NKID00/xlink033/README.md

# xlink033

Ultra-affordable debug probe built around the 30 cent MCU CH32X033F8P6, featuring:

- Bootstrap select button, so you won't need yet another probe to unbrick the probe itself!
- 5V and 3V3 dual switchable current-limited output
- RVSWD/SDI, JTAG/SWD, UART and RST signal
- Full-speed USB
- Link and activity indicator LED

### License

Hardware part (directory `hw/`) is distributed under CERN-OHL-S-2.0 or any later version.

<sub>
Copyright (C) 2025 NKID00 <br>
This source describes Open Hardware and is licensed under the CERN-OHL-S v2 or any later version. <br>
You may redistribute and modify this source and make products using it under the terms of the CERN-OHL-S v2 (https://ohwr.org/cern_ohl_s_v2.txt). <br>
This source is distributed WITHOUT ANY EXPRESS OR IMPLIED WARRANTY, INCLUDING OF MERCHANTABILITY, SATISFACTORY QUALITY AND FITNESS FOR A PARTICULAR PURPOSE. Please see the CERN-OHL-S v2 for applicable conditions. <br>
As per CERN-OHL-S v2 section 4, should You produce hardware based on this source, You must where practicable maintain the Source Location (https://github.com/NKID00/xlink033) visible on the external case of the Gizmo or other products you make using this source. <br>
</sub><br>

Software part (directory `sw/`) is distributed under GPL-3.0-or-later.

<sub>
Copyright (C) 2025 NKID00 <br>
This program is free software: you can redistribute it and/or modify it under the terms of the GNU General Public License as published by the Free Software Foundation, either version 3 of the License, or (at your option) any later version. <br>
This program is distributed in the hope that it will be useful, but WITHOUT ANY WARRANTY; without even the implied warranty of MERCHANTABILITY or FITNESS FOR A PARTICULAR PURPOSE.  See the GNU General Public License for more details. <br>
You should have received a copy of the GNU General Public License along with this program.  If not, see &le;https://www.gnu.org/licenses/&gt;.
</sub>
