NKID00/xlink033/hw/xlink033.pdf

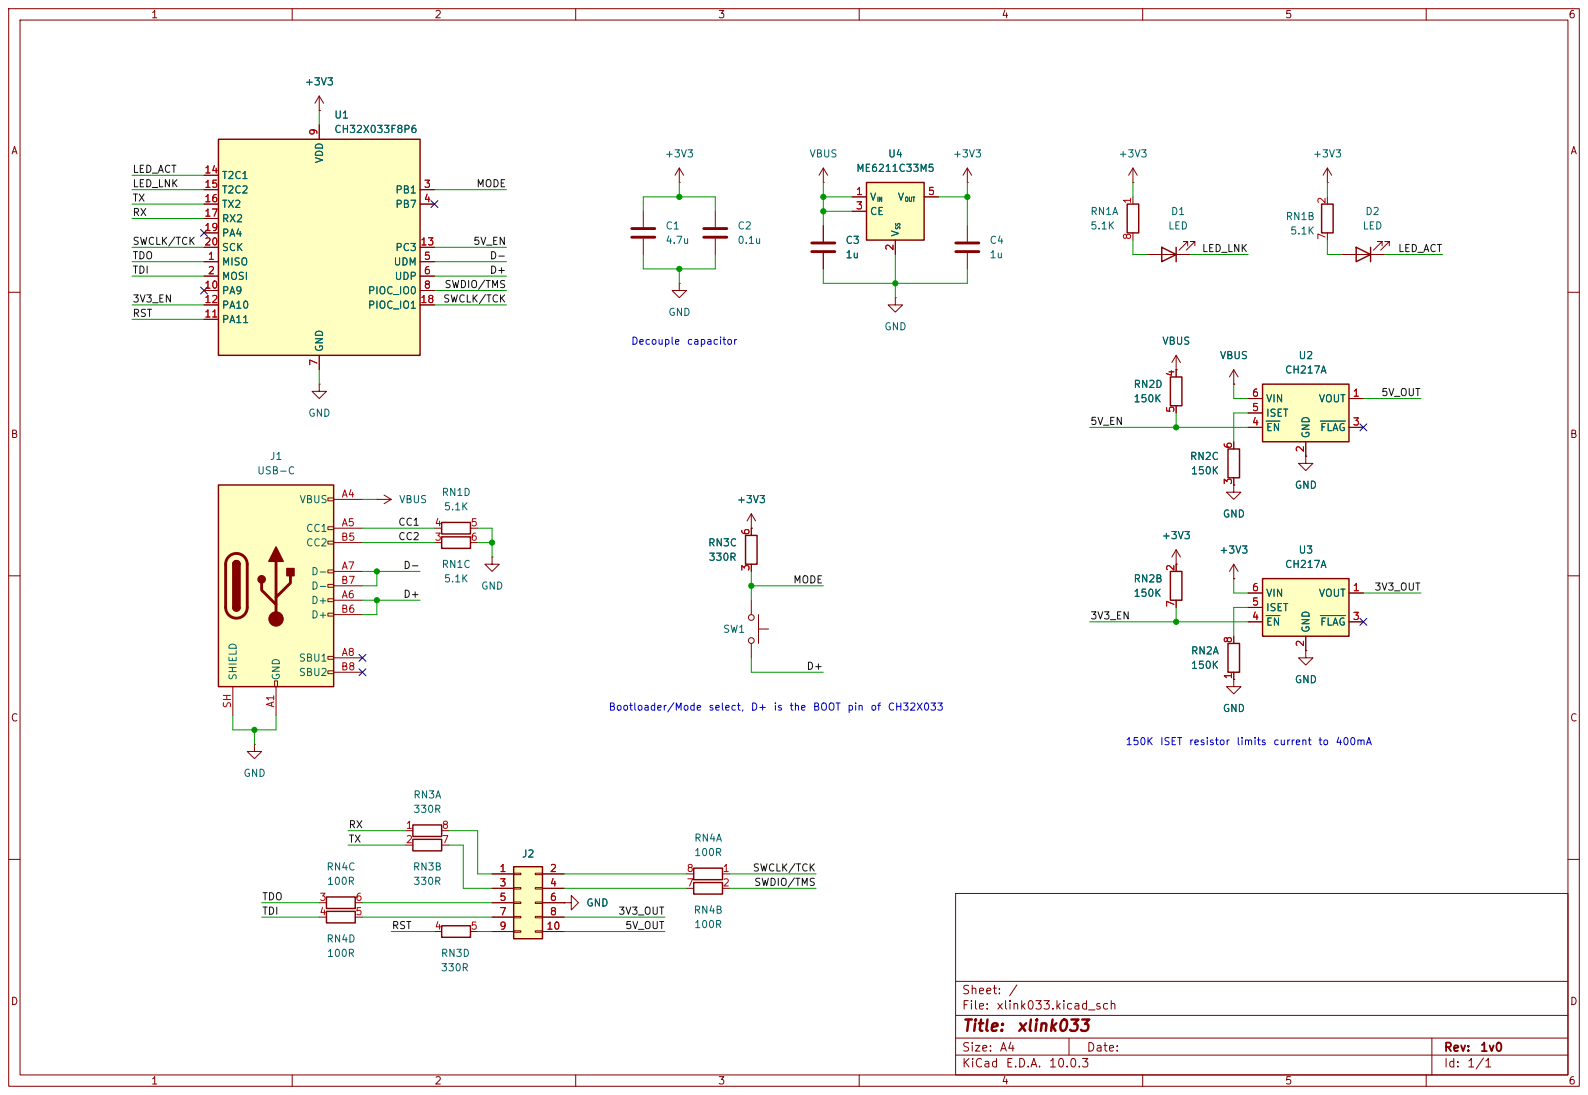
[picture p1: page 1]

9 MISO 1 MOSI 2 PB1 3 PB7 4 UDM 5 UDP 6 PIOC_IO0 8 PA9 10 PA11 11 PA10 12 PC3 13

Size: A4 | Rev: 1v0
KiCad E.D.A. 10.0.3 | Id: 1/1
