NKID00/xlink033/hw/xlink033.kicad_pcb

## KiCad design hw/xlink033.kicad_pcb (2026-09-29)

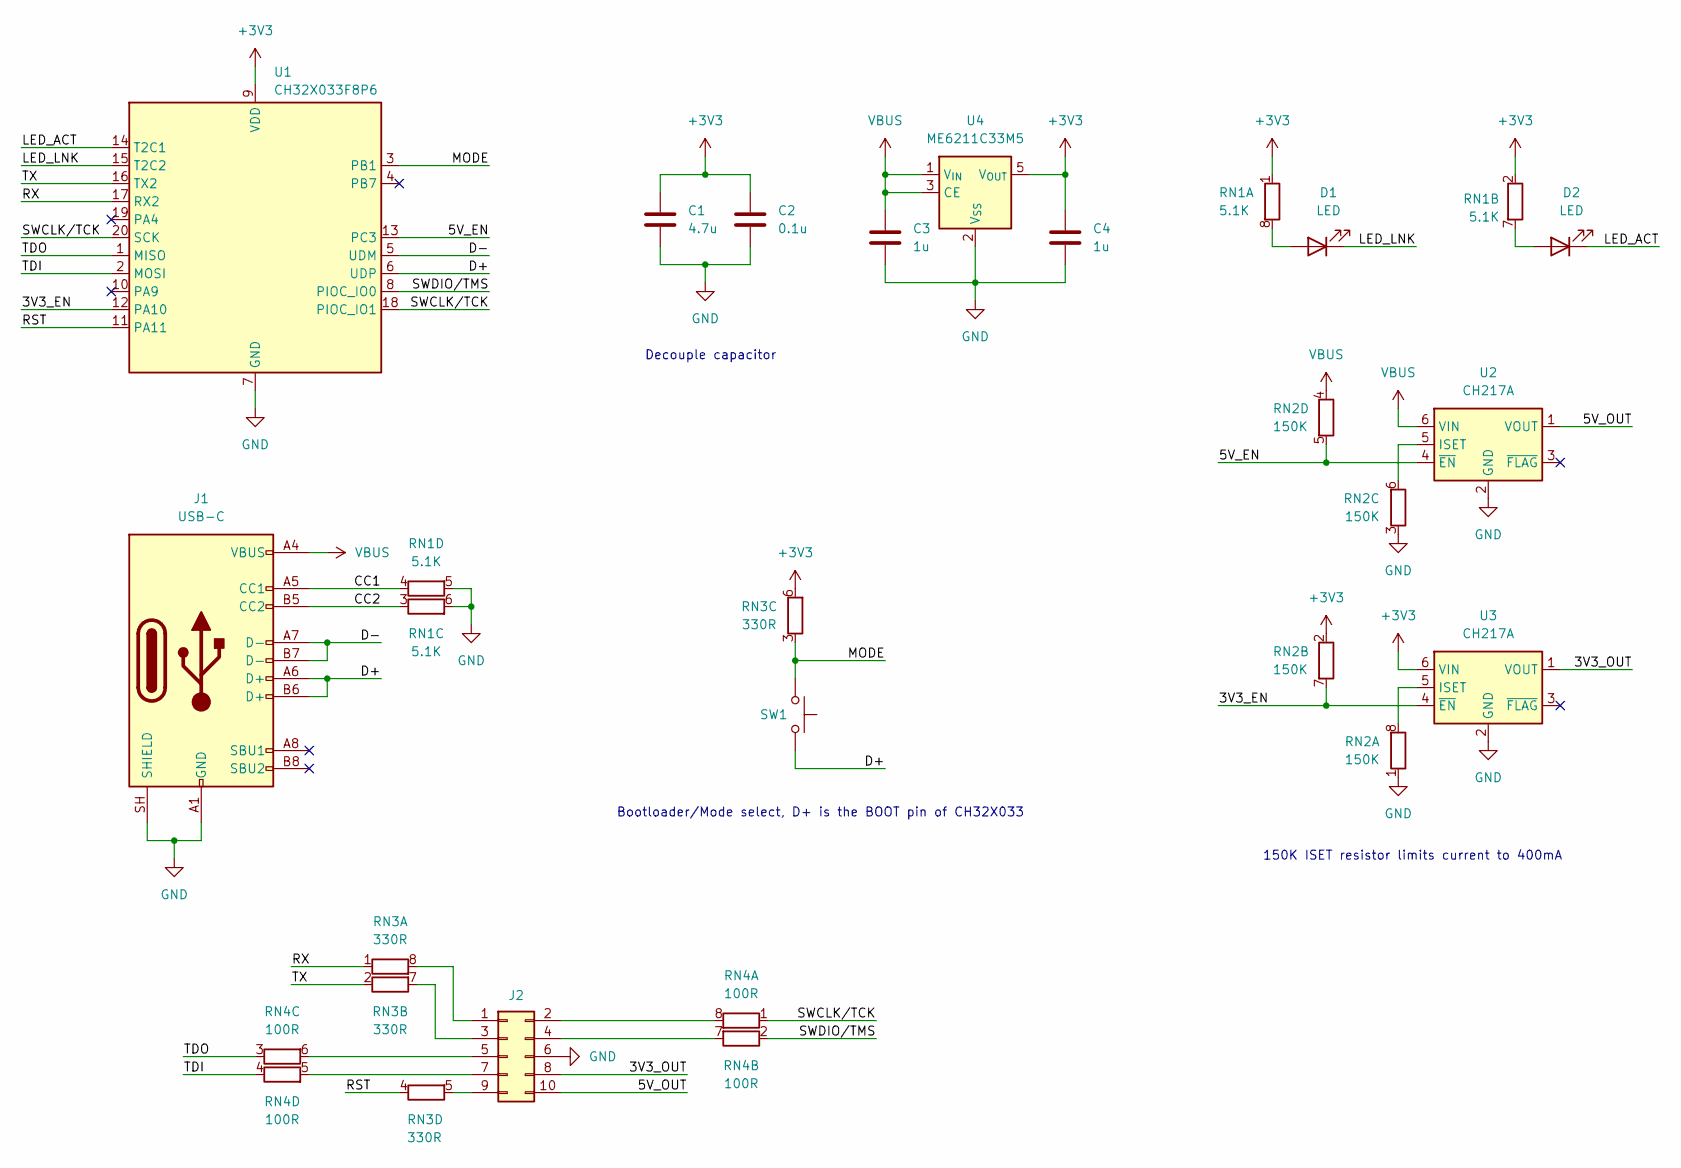
[picture p2: schematic xlink033.kicad_sch]

Parts:
C1: 4.7u; C_0603_1608Metric
C2: 0.1u; C_0603_1608Metric
C3, C4: 1u; C_0603_1608Metric
D1, D2: LED; LED_0603_1608Metric
J1: USB-C; USB_C_Receptacle_GCT_USB4105-xx-A_16P_TopMnt_Horizontal
J2: PinHeader_2x05_P2.54mm_Horizontal
RN1: 5.1K; R_Array_Convex_4x0603
RN2: 150K; R_Array_Convex_4x0603
RN3: 330R; R_Array_Convex_4x0603
RN4: 100R; R_Array_Convex_4x0603
SW1: SW_SPST_TS-1088-xR020
U1: CH32X033F8P6; TSSOP-20_4.4x6.5mm_P0.65mm
U2, U3: CH217A; SOT-23-6
U4: ME6211C33M5; SOT-23-5

Connections:
+3V3: C1.1, C2.1, C4.1, RN1.1 (R1.1), RN1.2 (R2.1), RN2.2 (R2.1), RN3.6 (R3.2), U1.9 (VDD), U3.6 (VIN), U4.5 (V_{OUT})
/3V3_EN: RN2.7 (R2.2), U1.12 (PA10), U3.4 (~EN)
/3V3_OUT: J2.8, U3.1 (VOUT)
/5V_EN: RN2.5 (R4.2), U1.13 (PC3), U2.4 (~EN)
/5V_OUT: J2.10, U2.1 (VOUT)
/CC1: J1.A5 (CC1), RN1.4 (R4.1)
/CC2: J1.B5 (CC2), RN1.3 (R3.1)
/D+: J1.A6 (D+), J1.B6 (D+), SW1.2, U1.6 (UDP)
/D-: J1.A7 (D-), J1.B7 (D-), U1.5 (UDM)
/LED_ACT: D2.1 (K), U1.14 (T2C1)
/LED_LNK: D1.1 (K), U1.15 (T2C2)
/MODE: RN3.3 (R3.1), SW1.1, U1.3 (PB1)
/RST: RN3.4 (R4.1), U1.11 (PA11)
/RX: RN3.1 (R1.1), U1.17 (RX2)
/SWCLK/TCK: RN4.1 (R1.1), U1.18 (PIOC_IO1), U1.20 (SCK)
/SWDIO/TMS: RN4.2 (R2.1), U1.8 (PIOC_IO0)
/TDI: RN4.4 (R4.1), U1.2 (MOSI)
/TDO: RN4.3 (R3.1), U1.1 (MISO)
/TX: RN3.2 (R2.1), U1.16 (TX2)
GND: C1.2, C2.2, C3.2, C4.2, J1.A1 (GND), J1.A12 (GND), J1.B1 (GND), J1.B12 (GND), J1.SH (SHIELD), J2.6, RN1.5 (R4.2), RN1.6 (R3.2), RN2.1 (R1.1), RN2.3 (R3.1), U1.7 (GND), U2.2 (GND), U3.2 (GND), U4.2 (V_{SS})
unnamed: D1.2 (A), RN1.8 (R1.2)
unnamed: D2.2 (A), RN1.7 (R2.2)
unnamed: J2.1, RN3.8 (R1.2)
unnamed: J2.2, RN4.8 (R1.2)
unnamed: J2.3, RN3.7 (R2.2)
unnamed: J2.4, RN4.7 (R2.2)
unnamed: J2.5, RN4.6 (R3.2)
unnamed: J2.7, RN4.5 (R4.2)
unnamed: J2.9, RN3.5 (R4.2)
unnamed: RN2.8 (R1.2), U3.5 (ISET)
unnamed: RN2.6 (R3.2), U2.5 (ISET)
VBUS: C3.1, J1.A4 (VBUS), J1.A9 (VBUS), J1.B4 (VBUS), J1.B9 (VBUS), RN2.4 (R4.1), U2.6 (VIN), U4.1 (V_{IN}), U4.3 (CE)

Notes on the sheet:
Bootloader/Mode select, D+ is the BOOT pin of CH32X033
150K ISET resistor limits current to 400mA
Decouple capacitor

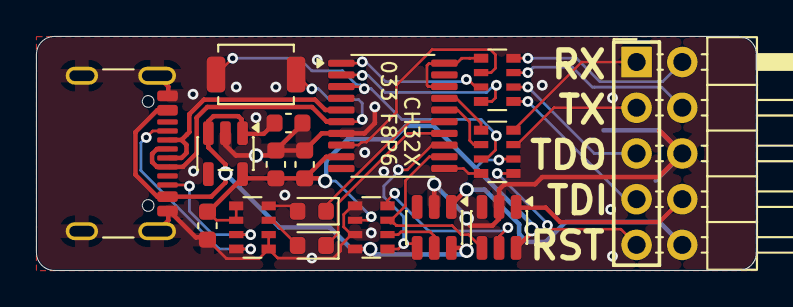
[picture p3: board xlink033.kicad_pcb from above]

Board: 2 copper layers, 40.0 x 13.0 mm, 17 parts (0 on the bottom side), 32 nets.
