NKID00/xlink033/(commit log)

2025-11-23 feat: init
    [xlink033.kicad_pcb, xlink033.kicad_sch]
2025-11-24 feat: add pdf
    [xlink033.kicad_pcb]
2026-09-29 fix: adjust led route and resistor values, bump to 1v0
    [xlink033.kicad_pcb, xlink033.kicad_sch]
2026-10-07 feat: single-buffered uart tx
2026-10-10 feat: double-buffered uart tx
